ZeniteSolar/MSR22/README.md

# MSR22
Módulo para comunicação serial I2C e USART com duas entradas para leituras analógicas.

Com dois acessos ao barramento I2C e um para USART este módulo foi projetado para os sensores MPU6050 e o módulo GPS Ublox M8N.
