ZeniteSolar/MSR22/hardware/serialcommunicationmod.kicad_pcb

## KiCad design hardware/serialcommunicationmod.kicad_pcb (2022-07-01)

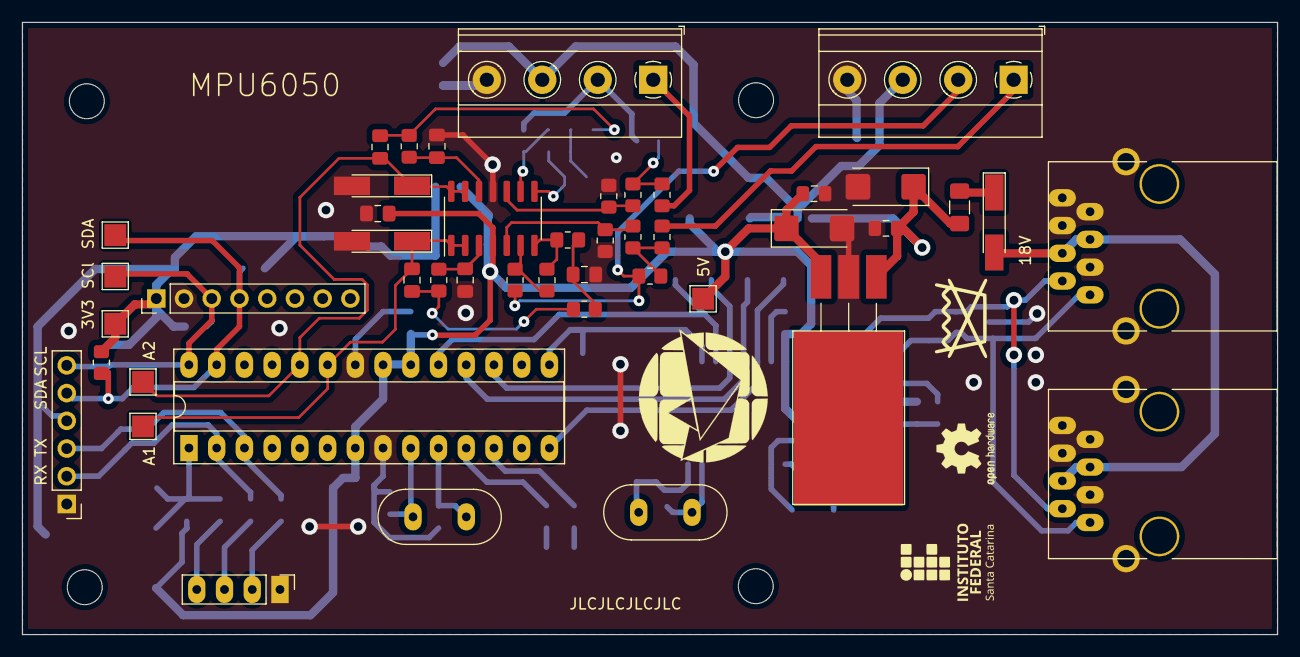
[picture p3: board serialcommunicationmod.kicad_pcb from above]

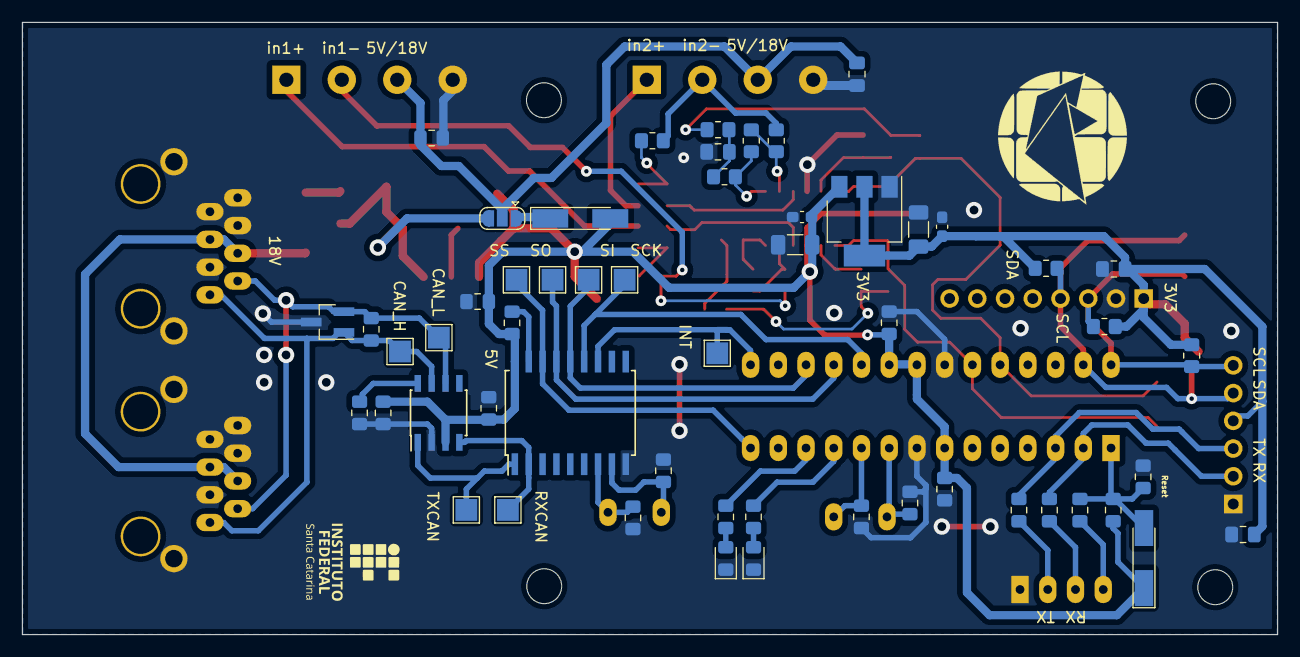
[picture p4: board serialcommunicationmod.kicad_pcb from below]

Board: 2 copper layers, 115.0 x 56.1 mm, 110 parts (56 on the bottom side), 55 nets.

Parts:
C4, C5, C6, C7, C8, C9, C374: 100n; C_0805_2012Metric_Pad1.18x1.45mm_HandSolder
C101, C103, C104: 100nF; C_0805_2012Metric_Pad1.18x1.45mm_HandSolder
C102, C201, C202, C205, C401, C402, C405, C406, C502, C503: 100nF; C_0805_2012Metric_Pad1.15x1.40mm_HandSolder
C203, C204, C403, C404: 22pF; C_0805_2012Metric_Pad1.15x1.40mm_HandSolder
C407, C410: 1u; C_1206_3216Metric_Pad1.33x1.80mm_HandSolder
C408, C409: 100n; C_0603_1608Metric_Pad1.08x0.95mm_HandSolder
C501, C504: 1uF; CP_EIA-6032-20_AVX-F_Pad2.25x2.35mm_HandSolder
D2, D3: 4V7; D_MiniMELF_Handsoldering
D101, D401, D501: LL4148; D_MiniMELF_Handsoldering
D201: D_TVS_Dual_AAC; SOT-23_Handsoldering
D402: LED2; LED_0805_2012Metric_Pad1.15x1.40mm_HandSolder
D403: LED1; LED_0805_2012Metric_Pad1.15x1.40mm_HandSolder
F501: 500mA; Fuse_1206_3216Metric_Pad1.42x1.75mm_HandSolder
H101, H102, H103, H104: MountingHole; MountingHole_3.2mm_M3
J101, J102: SENSOR; TerminalBlock_Phoenix_MKDS-1,5-4-5.08_1x04_P5.08mm_Horizont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
J103: Conn_01x08; PinHeader_1x08_P2.54mm_Vertical
J104: Conn_01x06; PinHeader_1x06_P2.54mm_Vertical
J401: USART; PinHeader_1x04_P2.54mm_Vertical
J601, J602: RJ45; RJ45_YH59_01
JP101: jmp; SolderJumper-3_P1.3mm_Open_RoundedPad1.0x1.5mm
LOGO101: Logo_Open_Hardware_Small; OSHW-Logo2_7.3x6mm_SilkScreen
R4, R5, R6, R7, R8, R9, R27, R28, R30, R32, R34, R35, R37, R38, R43, R44, R45, R46: 1k; R_0805_2012Metric_Pad1.20x1.40mm_HandSolder
R101, R102, R103, R104: 10k; R_0805_2012Metric_Pad1.20x1.40mm_HandSolder
R201: 120; R_0805_2012Metric_Pad1.15x1.40mm_HandSolder
R202: 4k7; R_0805_2012Metric_Pad1.15x1.40mm_HandSolder
R203, R401: 10k; R_0805_2012Metric_Pad1.15x1.40mm_HandSolder
R402, R403, R404, R405: 1k; R_0805_2012Metric_Pad1.15x1.40mm_HandSolder
SYM101, SYM102: SYM_Radioactive_Radiation_Small; symbol_logoZenite
SYM103: SYM_Radioactive_Radiation_Small; symbol_naolavar
SYM104, SYM105: SYM_LASER_Small; synbol_logoifsc
TP101: 5V; TestPoint_Pad_2.0x2.0mm
TP102: 3V3; TestPoint_Pad_2.0x2.0mm
TP201: SI; TestPoint_Pad_2.0x2.0mm
TP202: SO; TestPoint_Pad_2.0x2.0mm
TP203: TXCAN; TestPoint_Pad_2.0x2.0mm
TP204: RXCAN; TestPoint_Pad_2.0x2.0mm
TP205: SC; TestPoint_Pad_2.0x2.0mm
TP206: SCK; TestPoint_Pad_2.0x2.0mm
TP207: CAN_H; TestPoint_Pad_2.0x2.0mm
TP208: CAN_L; TestPoint_Pad_2.0x2.0mm
TP209: INT; TestPoint_Pad_2.0x2.0mm
TP210, TP211: TestPoint_Pad_2.0x2.0mm
TP601: SDA; TestPoint_Pad_2.0x2.0mm
TP602: SCL; TestPoint_Pad_2.0x2.0mm
U201: MCP2551-I/SN; SOIC-8_3.9x4.9mm_P1.27mm
U202: MCP2515-xSO; SOIC-18W_7.5x11.6mm_P1.27mm
U301: LM324; SOIC-14_3.9x8.7mm_P1.27mm
U302: DIP-28_W7.62mm_Socket_LongPads
U401: AMS1117-3.3; SOT-223-3_TabPin2
U501: LM7805; TO-220-3_Horizontal_TabDown_SMD
Y201, Y401: 16MHz; Crystal_HC49-U_Vertical

Connections:
+3V3: C103.1, C104.1, C409.2, C410.2, J103.1, J104.4, R101.1, R102.1, R103.1, R104.1, TP102.1, U401.2 (VO)
+5V: C201.1, C202.1, C205.1, C374.1, C401.1, C402.2, C407.2, C408.2, C503.1, C504.1, D101.2 (A), D401.1 (K), R203.1, R401.1, TP101.1, U201.3 (VDD), U202.18 (VDD), U301.4 (V+), U302.7 (VCC), U302.20 (AVCC), U302.21 (AREF), U401.3 (VI), U501.3 (VO)
/CANBUS CONN/CAN_18V: D501.2 (A), J601.4, J601.5, J602.4, J602.5
/CANBUS CONN/CAN_H: D201.1 (A1), J601.1, J602.1, R201.2, TP207.1, U201.7 (CANH)
/CANBUS CONN/CAN_L: D201.2 (A2), J601.2, J602.2, R201.1, TP208.1, U201.6 (CANL)
/CANBUS/RXCAN: TP204.1, U201.4 (RXD), U202.2 (RXCAN)
/CANBUS/TXCAN: TP203.1, U201.1 (TXD), U202.1 (TXCAN)
/MCU/LED1: R405.1, U302.11 (PD5)
/MCU/LED2: R404.1, U302.12 (PD6)
/MCU/MCP_INT: TP209.1, U202.12 (~INT), U302.15 (PB1)
/MCU/MCP_SS: TP205.1, U202.16 (~CS), U302.14 (PB0)
/MCU/RESET: C405.1, C406.2, D401.2 (A), R401.2, U302.1 (~RESET/PC6)
/MCU/analog1: C7.2, D3.1 (K), TP210.1, U301.1, U301.2 (-), U302.23 (PC0)
/MCU/analog2: C6.2, D2.1 (K), TP211.1, U301.13 (-), U301.14, U302.24 (PC1)
/MISO: TP202.1, U202.15 (SO), U302.18 (PB4)
/MOSI: TP201.1, U202.14 (SI), U302.17 (PB3)
/OPAMP/in1+: J102.1, R27.2
/OPAMP/in1-: J102.2, R30.1, R34.1
/OPAMP/in2+: J101.1, R28.2
/OPAMP/in2-: J101.2, R32.1, R37.1
/POWER SUPPLY/+18V_OUT: C501.1, C502.1, F501.2, JP101.3 (B), U501.1 (VI)
/RX: J104.2, R402.1, U302.2 (PD0)
/SCK: TP206.1, U202.13 (SCK), U302.19 (PB5)
/SCL: J103.3, J104.6, R101.2, R103.2, TP602.1, U302.28 (PC5)
/SDA: J103.4, J104.5, R102.2, R104.2, TP601.1, U302.27 (PC4)
/TX: J104.3, R403.1, U302.3 (PD1)
GND: C4.2, C5.2, C8.2, C9.2, C101.2, C102.2, C103.2, C104.2, C201.2, C202.2, C203.2, C204.2, C205.2, C374.2, C401.2, C402.1, C403.2, C404.2, C406.1, C407.1, C408.1, C409.1, C410.1, C501.2, C502.2, C503.2, C504.2, D2.2 (A), D3.2 (A), D201.3 (common), D402.1 (K), D403.1 (K), J101.4, J102.4, J103.2, J104.1, J401.1, J601.3, J601.6, J601.7, J601.8, J601.9 (SH), J602.3, J602.6, J602.7, J602.8, J602.9 (SH), R44.2, R46.2, R202.2, U201.2 (VSS), U202.9 (VSS), U301.11 (V-), U302.8 (GND), U302.22 (GND), U401.1 (GND), U501.2 (GND)
unnamed: C4.1, R4.1, R6.2
unnamed: C5.1, R5.1, R7.2
unnamed: C6.1, R6.1, R8.2
unnamed: C7.1, R7.1, R9.2
unnamed: C8.1, R8.1, U301.12 (+)
unnamed: C9.1, R9.1, U301.3 (+)
unnamed: C101.1, C102.1, J101.3, J102.3, JP101.2 (C)
unnamed: C203.1, U202.7 (OSC2), Y201.1
unnamed: C204.1, U202.8 (OSC1), Y201.2
unnamed: C403.1, U302.10 (XTAL2/PB7), Y401.1
unnamed: C404.1, U302.9 (XTAL1/PB6), Y401.2
unnamed: C405.2, J401.4
unnamed: D101.1 (K), JP101.1 (A)
unnamed: D402.2 (A), R404.2
unnamed: D403.2 (A), R405.2
unnamed: D501.1 (K), F501.1
unnamed: J401.2, R403.2
unnamed: J401.3, R402.2
unnamed: R4.2, R45.2, U301.8
unnamed: R27.1, R30.2, R35.1
unnamed: R28.1, R32.2, R38.1
unnamed: R34.2, R43.1, U301.6 (-)
unnamed: R35.2, R44.1, U301.5 (+)
unnamed: R37.2, R45.1, U301.9 (-)
unnamed: R38.2, R46.1, U301.10 (+)
unnamed: R5.2, R43.2, U301.7
unnamed: R202.1, U201.8 (STBY)
unnamed: R203.2, U202.17 (~RESET)
