ZeniteSolar/MSR22/firmware/src/machine.c

#include "machine.h"

volatile state_machine_t state_machine;
volatile system_flags_t system_flags;
volatile error_flags_t error_flags;
volatile measurements_t measurements;
volatile uint8_t machine_clk;
volatile uint8_t total_errors; // Contagem de ERROS
volatile uint16_t machine_clk_divider;
volatile uint16_t led_clk_div;
volatile uint16_t print_clk_div;

/**
 * @brief
 */
void machine_init(void) {
  // clr_bit(PRR0, PRTIM2);                          // Activates clock

  // MODE 2 -> CTC with TOP on OCR1
  TCCR2A = (1 << WGM21) | (0 << WGM20)      // mode 2
           | (0 << COM2B1) | (0 << COM2B0)  // do nothing
           | (0 << COM2A1) | (0 << COM2A0); // do nothing

  TCCR2B =
#if MACHINE_TIMER_PRESCALER == 1
      (0 << CS22) | (0 << CS21) | (1 << CS20) // Prescaler N=1
#elif MACHINE_TIMER_PRESCALER == 8
      (0 << CS22) | (1 << CS21) | (0 << CS20) // Prescaler N=8
#elif MACHINE_TIMER_PRESCALER == 32
      (0 << CS22) | (1 << CS21) | (1 << CS20) // Prescaler N=32
#elif MACHINE_TIMER_PRESCALER == 64
      (1 << CS22) | (0 << CS21) | (0 << CS20) // Prescaler N=64
#elif MACHINE_TIMER_PRESCALER == 128
      (1 << CS22) | (0 << CS21) | (1 << CS20) // Prescaler N=128
#elif MACHINE_TIMER_PRESCALER == 256
      (1 << CS22) | (1 << CS21) | (0 << CS20) // Prescaler N=256
#elif MACHINE_TIMER_PRESCALER == 1024
      (1 << CS22) | (1 << CS21) | (1 << CS20) // Prescaler N=1024
#else
      0
#endif
      | (0 << WGM22); // mode 2

  OCR2A = MACHINE_TOP_CTC; // OCR2A = TOP = fcpu/(N*2*f) -1
                           // (TOP+1)*N*2/fcpu = 1/f

  TIMSK2 |= (1 << OCIE2A); // Activates interruption

  set_machine_initial_state();
  set_state_initializing();
}

/**
 * @brief set machine initial state
 */
inline void set_machine_initial_state(void) {
  error_flags.all = 0;
  machine_clk = machine_clk_divider = led_clk_div = 0;
}

/**
 * @brief set error state
 */
inline void set_state_error(void) {
  VERBOSE_MSG_MACHINE(usart_send_string("\n>>>STATE ERROR\n"));
  state_machine = STATE_ERROR;
}

/**
 * @brief set initializing state
 */
inline void set_state_initializing(void) {
  VERBOSE_MSG_MACHINE(usart_send_string("\n>>>INITIALIZING STATE\n"));
  state_machine = STATE_INITIALIZING;
}

/**
 * @brief set idle state
 */
inline void set_state_idle(void) {
  VERBOSE_MSG_MACHINE(usart_send_string("\n>>>IDLE STATE\n"));
  state_machine = STATE_IDLE;
}

/**
 * @brief set running state
 */
inline void set_state_running(void) {
  VERBOSE_MSG_MACHINE(usart_send_string("\n>>>RUNNING STATE\n"));
  state_machine = STATE_RUNNING;
}

/**
 * @brief set reset state
 */

inline void set_state_reset(void) {
  VERBOSE_MSG_MACHINE(usart_send_string("\n>>>RESET STATE\n"));
  state_machine = STATE_RESET;
}

/**
 * @breif prints the configurations and definitions
 */
inline void print_configurations(void) {
  VERBOSE_MSG_MACHINE(usart_send_string("CONFIGURATIONS:\n"));

  VERBOSE_MSG_MACHINE(usart_send_string("\nadc_f: "));
  VERBOSE_MSG_MACHINE(usart_send_uint16(ADC_FREQUENCY));
  VERBOSE_MSG_MACHINE(usart_send_string(", adc0 size: "));
  VERBOSE_MSG_MACHINE(usart_send_uint16(cbuf_adc0_SIZE));
  VERBOSE_MSG_MACHINE(usart_send_string(", adc1 size: "));
  VERBOSE_MSG_MACHINE(usart_send_uint16(cbuf_adc0_SIZE));
  VERBOSE_MSG_MACHINE(usart_send_string("\nmachine_f: "));
  VERBOSE_MSG_MACHINE(usart_send_uint16(MACHINE_FREQUENCY));

  VERBOSE_MSG_MACHINE(usart_send_char('\n'));
}

/**
 * @brief prints the system flags
 */
inline void print_system_flags(void) {
  // VERBOSE_MSG_MACHINE(usart_send_string(" EN "));
  // VERBOSE_MSG_MACHINE(usart_send_char(48+system_flags.enable));
}

/**
 * @brief prints the error flags
 */
inline void print_error_flags(void) {
  // VERBOSE_MSG_MACHINE(usart_send_string(" errFl: "));
  // VERBOSE_MSG_MACHINE(usart_send_char(48+error_flags.no_canbus));
}

#define MA_PANEL_VOLTAGE ma_adc0()
#define MA_PANEL_CURRENT ma_adc1()

/**
 * @brief checks if the voltage of Battery level is ok for running state
 */
inline void check_battery_voltage(void) // sem panel
{
  if (measurements.bat_voltage_0 >= MAXIMUM_BATTERY_VOLTAGE ||
      measurements.bat_voltage_1 >= MAXIMUM_BATTERY_VOLTAGE) {
    error_flags.overvoltage = 1;
  } else if (measurements.bat_voltage_0 <= MINIMUM_BATTERY_VOLTAGE ||
             measurements.bat_voltage_1 <= MINIMUM_BATTERY_VOLTAGE) {
    error_flags.overvoltage = 1;
  } else
    error_flags.overvoltage = 0;
}

/**
 * @brief read and checks current levels
 */
inline void read_and_check_adcs(void) {
#ifdef ADC_ON
  measurements.bat_voltage_0 =
      MA_BATTERY_VOLTAGE_0;
  measurements.bat_voltage_1 =
      MA_BATTERY_VOLTAGE_1;

  switch (state_machine) {
  case STATE_INITIALIZING:
    check_battery_voltage();

    break;
  case STATE_IDLE:
    check_battery_voltage();

    break;
  case STATE_RUNNING:
    check_battery_voltage();

    break;
  default:
    break;
  }
#endif
}

/**
 * @brief Checks if the system is OK to run
 */
inline void task_initializing(void) {
#ifdef LED_ON
  set_led(LED1);
  set_led(LED2);
#endif

  set_machine_initial_state();

  VERBOSE_MSG_INIT(usart_send_string("System initialized without errors.\n"));
  set_state_idle();
}

/**
 * @brief waits for commands while checking the system
 */
inline void task_idle(void) {
#ifdef LED_ON
  if (led_clk_div++ >= IDLE_LED_CLK_DIV) {
    set_led(LED2);
    cpl_led(LED1);
    led_clk_div = 0;
  }
#endif

  set_state_running();
}

/**
 * @brief running task checks the system and apply the control action to pwm.
 */
inline void task_running(void) {
#ifdef LED_ON
  if (led_clk_div++ >= RUNNING_LED_CLK_DIV) {
    clr_led(LED2);
    cpl_led(LED1);
    led_clk_div = 0;
  }
#endif // LED_ON
}

/**
 * @brief error task checks the system and tries to medicine it.
 */
inline void task_error(void) {
#ifdef LED_ON
  if (led_clk_div++ >= ERROR_LED_CLK_DIV) {
    cpl_led(LED2);
    // set_led(LED1);
    led_clk_div = 0;
  }
#endif

  total_errors++; // incrementa a contagem de erros
  VERBOSE_MSG_ERROR(usart_send_string("The error code is: "));
  VERBOSE_MSG_ERROR(usart_send_uint16(error_flags.all));
  VERBOSE_MSG_ERROR(usart_send_char('\n'));

  if (error_flags.no_canbus)
    VERBOSE_MSG_ERROR(
        usart_send_string("\t - No canbus communication with MIC19!\n"));
  if (!error_flags.all)
    VERBOSE_MSG_ERROR(
        usart_send_string("\t - Oh no, it was some unknown error.\n"));

  VERBOSE_MSG_ERROR(usart_send_string("The error level is: "));
  VERBOSE_MSG_ERROR(usart_send_uint16(total_errors));
  VERBOSE_MSG_ERROR(usart_send_char('\n'));

  if (total_errors < 2) {
    VERBOSE_MSG_ERROR(usart_send_string("I will reset the machine state.\n"));
  }
  if (total_errors >= 20) {
    VERBOSE_MSG_ERROR(
        usart_send_string("The watchdog will reset the whole system.\n"));
    set_state_reset();
  }

  set_state_initializing();
}

/**
 * @brief reset error task just freezes the processor and waits for watchdog
 */
inline void task_reset(void) {
#ifndef WATCHDOG_ON
  // wdt_init();
#endif

  cli(); // disable interrupts

  VERBOSE_MSG_ERROR(usart_send_string("WAITING FOR A RESET!\n"));
  for (;;)
    ;
}

void print_infos(void) {
  static uint8_t i = 0;

  if (print_clk_div++ >= PRINT_INFOS_CLK_DIV) {
    print_clk_div = 0;
    usart_send_string("\nBatt 1 Volt: ");
    usart_send_uint16(measurements.bat_voltage_0);
    usart_send_string("\tBatt 2 Volt: ");
    usart_send_uint16(measurements.bat_voltage_1);
    switch (i++) {
    case 0:
      // usart_send_string("\ntestando: ");
      // usart_send_float(measurements.bat_voltage);
      break;
    case 1:
      break;
    case 2:
      break;
    default:
      // VERBOSE_MSG_MACHINE(usart_send_char('\n'));
      i = 0;
      break;
    }
  }
}

/**
 * @brief this is the machine state itself.
 */
inline void machine_run(void) {

  if (machine_clk) {

    machine_clk = 0;
#ifdef ADC_ON
    if (adc_data_ready) {
      adc_data_ready = 0;
      read_and_check_adcs();
    }

    switch (state_machine) {
    case STATE_INITIALIZING:
      task_initializing();

      break;
    case STATE_IDLE:
      task_idle();

      break;
    case STATE_RUNNING:
      task_running();
#ifdef PRINT_INFOS
      print_infos();
#endif /* PRINT_INFOS */
#ifdef CAN_ON
      can_app_task();
#endif /* CAN_ON */

      break;
    case STATE_ERROR:
      task_error();
      break;
    case STATE_RESET:
      __attribute__((fallthrough));
    default:
      task_reset();
      break;
    }

#endif /* ADC_ON */
  }
}

/**
 * @brief ISR para ações de controle
 */
ISR(TIMER2_COMPA_vect) { machine_clk = 1; }
