ZeniteSolar/MSR22/firmware/src/can_app.c

#include "can_app.h"
#include <math.h>

uint32_t can_app_send_state_clk_div;
uint32_t can_app_send_adc_0_clk_div;
uint32_t can_app_send_adc_1_clk_div;
/**
 * @brief Prints a can message via usart
 */
inline void can_app_print_msg(can_t *msg)
{
#ifdef USART_ON
    usart_send_string("ID: ");
    usart_send_uint16(msg->id);
    usart_send_string(". D: ");

    for(uint8_t i = 0; i < msg->length; i++){
      usart_send_uint16(msg->data[i]);
      usart_send_char(' ');
    }

    usart_send_string(". ERR: ");
    can_error_register_t err = can_read_error_register();
    usart_send_uint16(err.rx);
    usart_send_char(' ');
    usart_send_uint16(err.tx);
    usart_send_char('\n');
#endif
}

/**
* @brief Manages the canbus application protocol
*/
inline void can_app_task(void)
{
    check_can();

    if(can_app_send_state_clk_div++ >= CAN_APP_SEND_STATE_CLK_DIV){
#ifdef USART_ON
        VERBOSE_MSG_CAN_APP(usart_send_string("state msg was sent.\n"));
#endif
        can_app_send_state();
        can_app_send_state_clk_div = 0;
    }

    if(can_app_send_adc_0_clk_div++ >= CAN_APP_SEND_ADC_CLK_DIV){
#ifdef USART_ON
        VERBOSE_MSG_CAN_APP(usart_send_string("adc0 msg was sent.\n"));
#endif
        can_app_send_adc_0();
        can_app_send_adc_0_clk_div = 0;
    }

    if(can_app_send_adc_1_clk_div++ >= CAN_APP_SEND_ADC_CLK_DIV){
#ifdef USART_ON
        VERBOSE_MSG_CAN_APP(usart_send_string("adc1 msg was sent.\n"));
#endif
        can_app_send_adc_1();
        can_app_send_adc_1_clk_div = 0;
    }

}

inline void can_app_send_state(void)
{
    can_t msg;
    msg.id                                  = CAN_MSG_MSC19_1_STATE_ID;
    msg.length                              = CAN_MSG_GENERIC_STATE_LENGTH;
    msg.flags.rtr = 0;

    msg.data[CAN_MSG_GENERIC_STATE_SIGNATURE_BYTE]            = CAN_SIGNATURE_MSC19_1;
    msg.data[CAN_MSG_GENERIC_STATE_STATE_BYTE]      = (uint8_t) state_machine;
    msg.data[CAN_MSG_GENERIC_STATE_ERROR_BYTE]      = error_flags.all;

    can_send_message(&msg);

#ifdef VERBOSE_MSG_CAN_APP
    VERBOSE_MSG_CAN_APP(can_app_print_msg(&msg));
#endif
}

inline void can_app_send_adc_0(void)
{
    can_t msg;
    msg.id                                  = CAN_MSG_MSC19_1_ADC_ID;
    msg.length                              = CAN_MSG_MSC19_1_ADC_LENGTH;
    msg.flags.rtr = 0;

    msg.data[CAN_MSG_GENERIC_STATE_SIGNATURE_BYTE]            = CAN_SIGNATURE_MSC19_1;
    msg.data[CAN_MSG_MSC19_1_ADC_AVG_L_BYTE]  = LOW(measurements.bat_voltage_0);
    msg.data[CAN_MSG_MSC19_1_ADC_AVG_H_BYTE]  = HIGH(measurements.bat_voltage_0);
    msg.data[CAN_MSG_MSC19_1_ADC_MIN_L_BYTE] = 0; // TODO
    msg.data[CAN_MSG_MSC19_1_ADC_MIN_H_BYTE] = 0; // TODO
    msg.data[CAN_MSG_MSC19_1_ADC_MAX_L_BYTE] = 0; // TODO
    msg.data[CAN_MSG_MSC19_1_ADC_MAX_H_BYTE] = 0; // TODO

    can_send_message(&msg);
    
#ifdef VERBOSE_MSG_CAN_APP
    VERBOSE_MSG_CAN_APP(can_app_print_msg(&msg));
#endif

}

inline void can_app_send_adc_1(void)
{
    can_t msg;
    msg.id                                  = CAN_MSG_MSC19_2_ADC_ID;
    msg.length                              = CAN_MSG_MSC19_2_ADC_LENGTH;
    msg.flags.rtr = 0;

    msg.data[CAN_MSG_GENERIC_STATE_SIGNATURE_BYTE]            = CAN_SIGNATURE_MSC19_2;
    msg.data[CAN_MSG_MSC19_2_ADC_AVG_L_BYTE]  = LOW(measurements.bat_voltage_1);
    msg.data[CAN_MSG_MSC19_2_ADC_AVG_H_BYTE]  = HIGH(measurements.bat_voltage_1);
    msg.data[CAN_MSG_MSC19_2_ADC_MIN_L_BYTE]  = 0; // TODO
    msg.data[CAN_MSG_MSC19_2_ADC_MIN_H_BYTE]  = 0; // TODO
    msg.data[CAN_MSG_MSC19_2_ADC_MAX_L_BYTE]  = 0; // TODO
    msg.data[CAN_MSG_MSC19_2_ADC_MAX_H_BYTE]  = 0; // TODO

    can_send_message(&msg);

#ifdef VERBOSE_MSG_CAN_APP
    VERBOSE_MSG_CAN_APP(can_app_print_msg(&msg));
#endif

}


/**
 * @brief extracts the specific MIC19 STATE message
 * @param *msg pointer to the message to be extracted
 */
inline void can_app_extractor_mic17_state(can_t *msg)
{
    if(msg->data[CAN_MSG_GENERIC_STATE_SIGNATURE_BYTE] == CAN_SIGNATURE_MIC19){
        // zerar contador
        if(msg->data[CAN_MSG_GENERIC_STATE_ERROR_BYTE]){
            //ERROR!!!
        }
        /*if(contador == maximo)*/{
            //ERROR!!!
        }
    }
}

/**
 * @brief redirects a specific message extractor to a given message
 * @param *msg pointer to the message to be extracted
 */
inline void can_app_msg_extractors_switch(can_t *msg)
{
    if(msg->data[CAN_MSG_GENERIC_STATE_SIGNATURE_BYTE] == CAN_SIGNATURE_MIC19){
        switch(msg->id){
            case CAN_MSG_MIC19_STATE_ID:
#ifdef USART_ON
                VERBOSE_MSG_CAN_APP(usart_send_string("got a state msg: "));
#endif
                VERBOSE_MSG_CAN_APP(can_app_print_msg(msg));
                can_app_extractor_mic17_state(msg);
                break;
            default:
#ifdef USART_ON
                VERBOSE_MSG_CAN_APP(usart_send_string("got a unknown msg: "));
#endif
                VERBOSE_MSG_CAN_APP(can_app_print_msg(msg));
                break;
        }
    }
}

/**
 * @brief Manages to receive and extract specific messages from canbus
 */
inline void check_can(void)
{
    // If no messages is received from mic17 for
    // CAN_APP_CHECKS_WITHOUT_MIC19_MSG cycles, than it go to a specific error state.
    //VERBOSE_MSG_CAN_APP(usart_send_string("checks: "));
    //VERBOSE_MSG_CAN_APP(usart_send_uint16(can_app_checks_without_mic17_msg));
#ifdef CAN_DEPENDENT
    if(can_app_checks_without_mic17_msg++ >= CAN_APP_CHECKS_WITHOUT_MIC19_MSG){
#ifdef USART_ON
        VERBOSE_MSG_CAN_APP(usart_send_string("Error: too many cycles withtou message.\n"));
#endif
        can_app_checks_without_mic17_msg = 0;
        error_flags.no_canbus = 1;
        set_state_error();
    }
#endif

    if(can_check_message()){
        can_t msg;
        if(can_get_message(&msg)){
            can_app_msg_extractors_switch(&msg);
        }
    }
}
