ZeniteSolar/MSR22/(commit log)

2022-07-01 hardware: silkscreen updated with JLC. Finished.
    [K78Lxx-1000R3.stp, analog.kicad_sch, atmega328p.kicad_sch, canbus.kicad_sch, canbus_connector.kicad_sch, rj45.step, serialcommunicationmod.kicad_pcb, serialcommunicationmod.kicad_sch]
2025-03-19 commit inicial do modo voltimetro
2025-03-23 add missing prototypes
2025-03-23 using macros for led_clk_div, code cleanup
2025-03-23 thorough adc init, corrected channels switch case, improved macros
    [adc.c]
2025-03-23 Compiler safeguard for macros of ADC and machine timers
2025-04-04 fix adc prescaler
2025-06-03 using new adc functions, voltage limites, and led frequencies
2025-06-03 New adc functions, pretending to be MSC19 1 and 2
2025-06-03 minor changes to LED logic
2025-06-14 ADC msg: all 7 bytes present, not all implemented
